physiii/esp-drone/code/docs/en/rst/index.rst

ESP-Drone
===========
:link_to_translation:`zh_CN:[中文]`

**ESP-Drone** is an open source **drone solution** based on Espressif **ESP32/ESP32-S2** Wi-Fi chip, which can be controlled over a **Wi-Fi** network using a mobile APP or gamepad. ESP-Drone supports multiple flight modes, including `Stabilize mode`, `Height-hold mode`, and `Position-hold mode`. With **simple hardware**, **clear and extensible code architecture**, ESP-Drone can be used in **STEAM education** and other fields. The main code is ported from **Crazyflie** open source project with **GPL3.0** protocol.

This document describes the development guide for ESP-Drone project.

==================  ==================  ==================
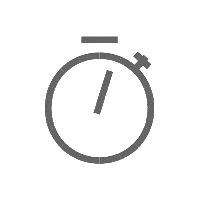
[picture p27: code/docs/_static/get-started.png]
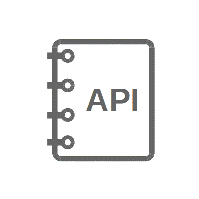
[picture p28: code/docs/_static/api-reference.png]
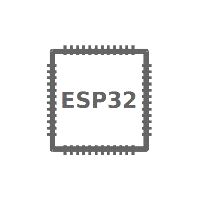
[picture p29: code/docs/_static/hw-reference.png]
_      _    _
------------------  ------------------  ------------------
`Get Started`_      `Develop Guide`_    `H/W Reference`_
==================  ==================  ==================


.. _Get Started: gettingstarted.html


.. _Develop Guide: gettingstarted.html


.. _H/W Reference: gettingstarted.html

.. toctree::
   :hidden:

   Get Started <gettingstarted>
   Set up Development Environment <getespidf>
   Development Guide <developerguide>
   Hardware Reference <hardware>
   Drivers <drivers>
   Flight Control System <system>
   Communications <communication>
   Notice <notice>
