physiii/esp-drone/code/docs/zh_CN/md/index.rst

ESP-Drone
===========

ESP-Drone 是基于乐鑫 ESP32/ESP32-S2 开发的小型无人机解决方案，可使用手机 APP 或游戏手柄通过 Wi-Fi 网络进行连接和控制。目前已支持自稳定飞行、定高飞行、定点飞行等多种模式。该方案硬件结构简单，代码架构清晰完善，方便功能扩展，可用于 STEAM 教育等领域。控制系统代码来自 Crazyflie 开源工程，使用 GPL3.0 开源协议。

本文档包含 ESP-Drone 基本的开发和使用说明。

==================  ==================  ==================
_          _         _
------------------  ------------------  ------------------
`快速入门`_          `开发指引`_         `硬件参考`_
==================  ==================  ==================


.. _快速入门: gettingstarted.html


.. _开发指引: developerguide.html


.. _硬件参考: hardware.html

.. toctree::
   :hidden:

   快速入门 <gettingstarted>
   环境搭建 <getespidf>
   开发指引 <developerguide>
   硬件参考 <hardware.md>
   驱动程序 <drivers.md>
   飞控系统 <system.md>
   通信协议 <communication.md>
   声明 <notice.md>
