physiii/esp-drone/code/docs/en/md/index.rst

ESP-Drone
===========

**ESP-Drone** is an open source **drone solution** based on espressif **ESP32-S2 / ESP32** Wi-Fi chip, which can be controlled through **Wi-Fi** network using mobile APP or gamepad. ESP-Drone supports multiple flight modes, `stabilize`, `height-hold`, `position-hold` and more. With **simple hardware**, **clear and extendible code architecture**, ESP-Drone can be used in **STEAM education** and other fields. The main code ported from **Crazyflie** open source project with **GPL3.0** protocol.

This document describes development and usage guide for the ESP-Drone project

==================  ==================  ==================
_      _    _
------------------  ------------------  ------------------
`Get Started`_      `Develop Guide`_    `H/W Reference`_
==================  ==================  ==================


.. _Get Started: gettingstarted.html


.. _Develop Guide: gettingstarted.html


.. _H/W Reference: gettingstarted.html

.. toctree::
   :hidden:

   Get Started <gettingstarted>
