physiii/esp-drone/code/docs/_static/burst_read_sequence.png

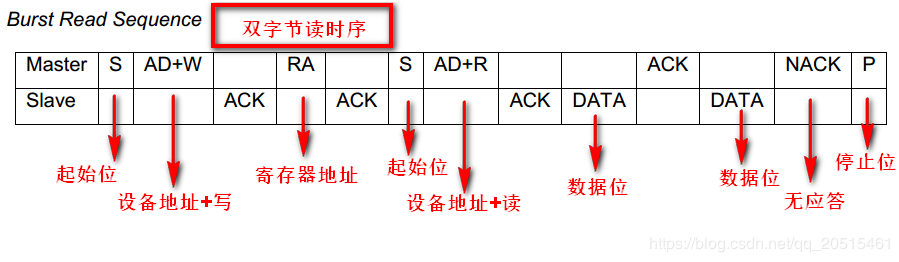
code/docs/_static/burst_read_sequence.png
