physiii/esp-drone/code/docs/_static/burst_write_sequence.png

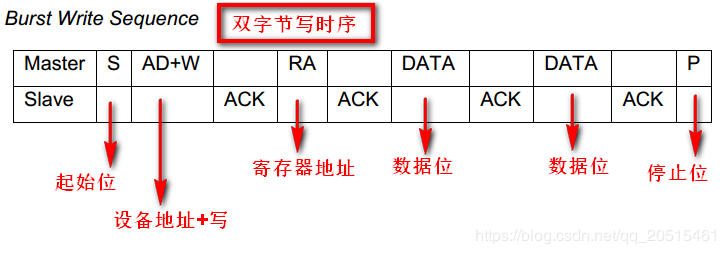
code/docs/_static/burst_write_sequence.png
