physiii/esp-drone/code/docs/_static/cover_page_pdf.jpg

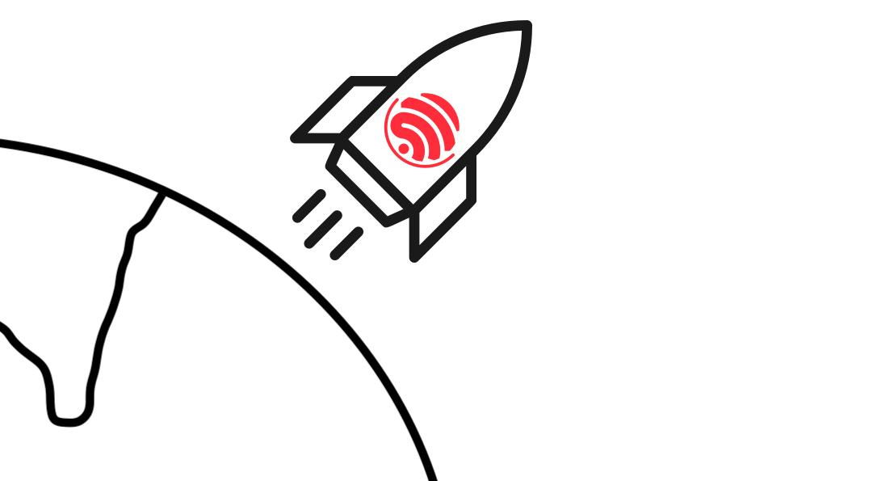
code/docs/_static/cover_page_pdf.jpg
