physiii/esp-drone/code/docs/_static/espdrone_s2_v1_2.png

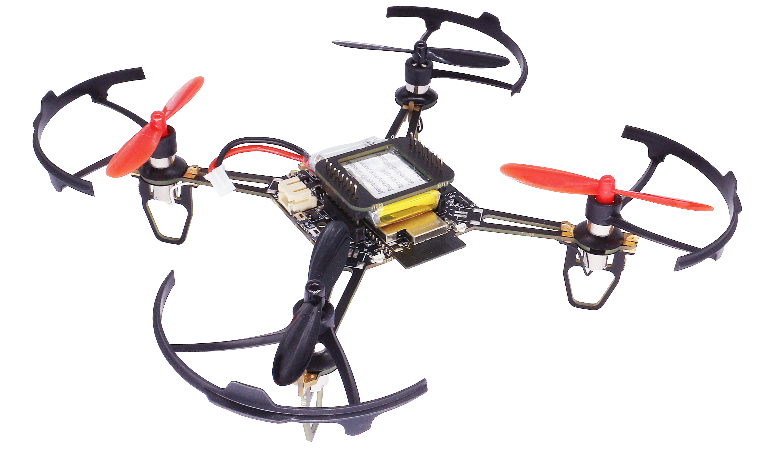
code/docs/_static/espdrone_s2_v1_2.png
