physiii/esp-drone/code/docs/_static/espdrone_s2_v1_2_diretion.png

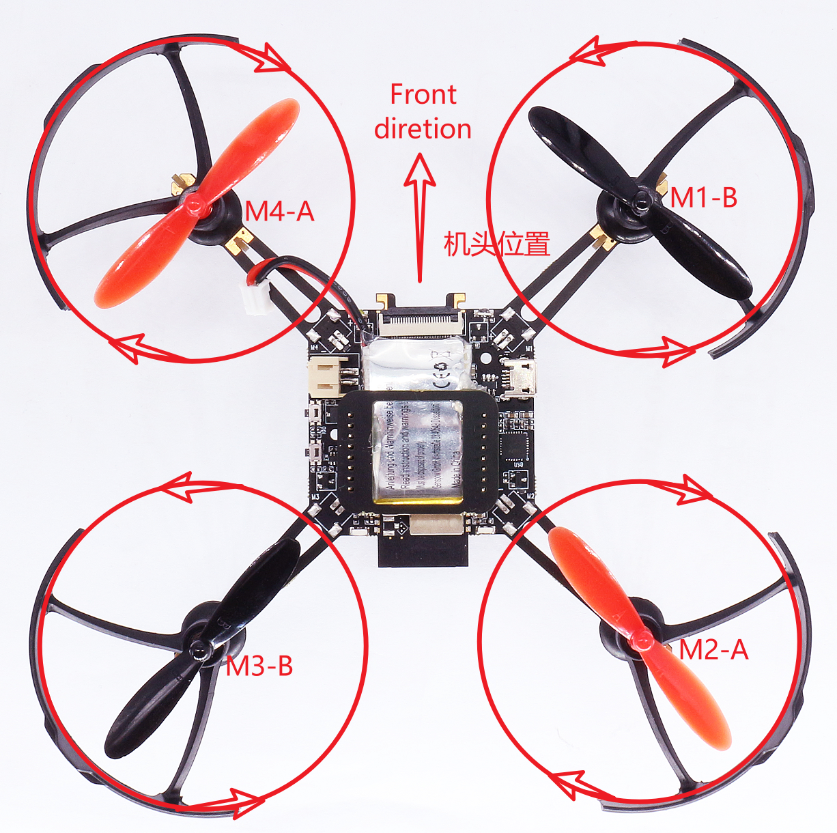
code/docs/_static/espdrone_s2_v1_2_diretion.png
