physiii/esp-drone/code/docs/_static/espilot_app.png

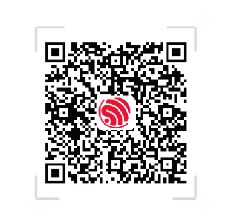
code/docs/_static/espilot_app.png
