physiii/esp-drone/code/docs/_static/esplane_v1_specification.jpg

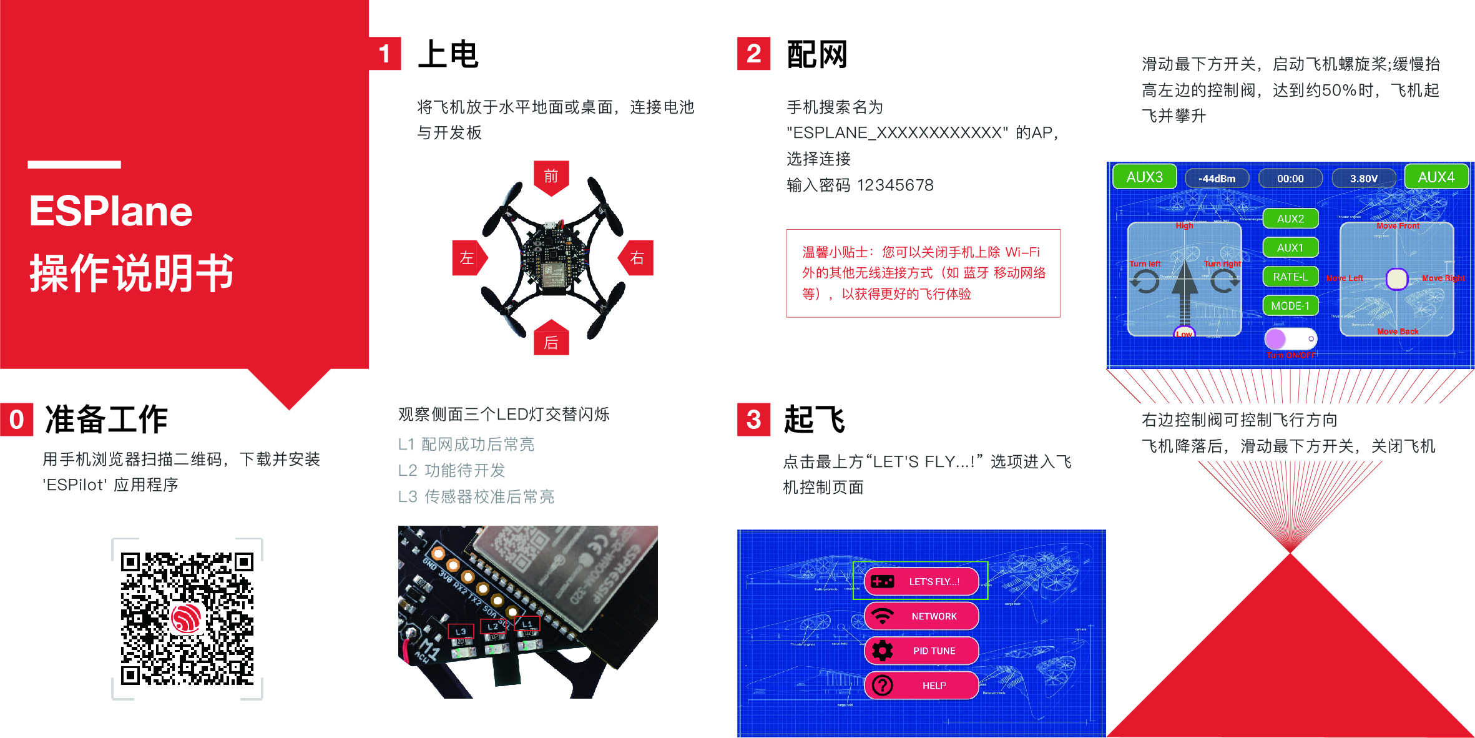
code/docs/_static/esplane_v1_specification.jpg
