physiii/esp-drone/code/docs/_static/gamepad.jpg

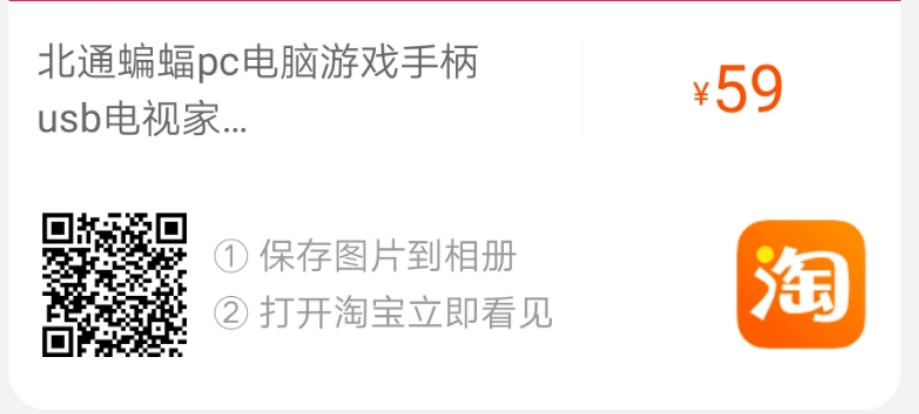
code/docs/_static/gamepad.jpg
