physiii/esp-drone/code/docs/_static/i2c_signal.png

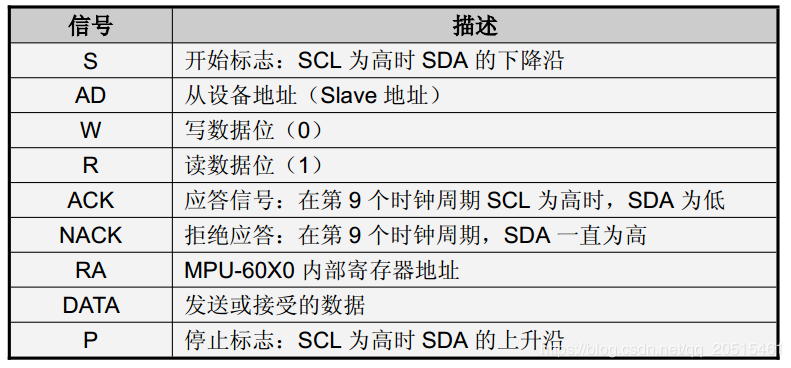
code/docs/_static/i2c_signal.png
