physiii/esp-drone/code/docs/_static/log_motion.png

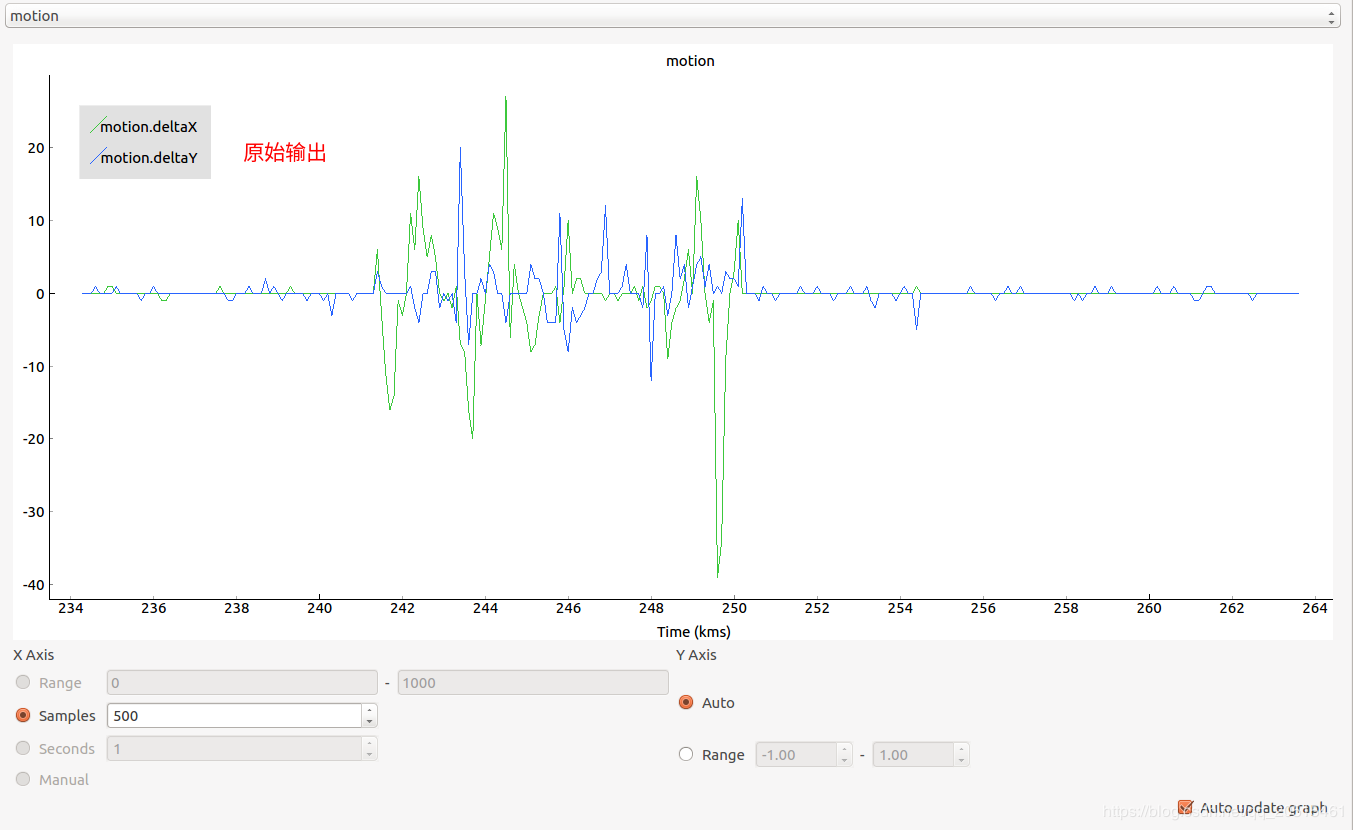
code/docs/_static/log_motion.png
