physiii/esp-drone/code/docs/_static/motors_direction.png

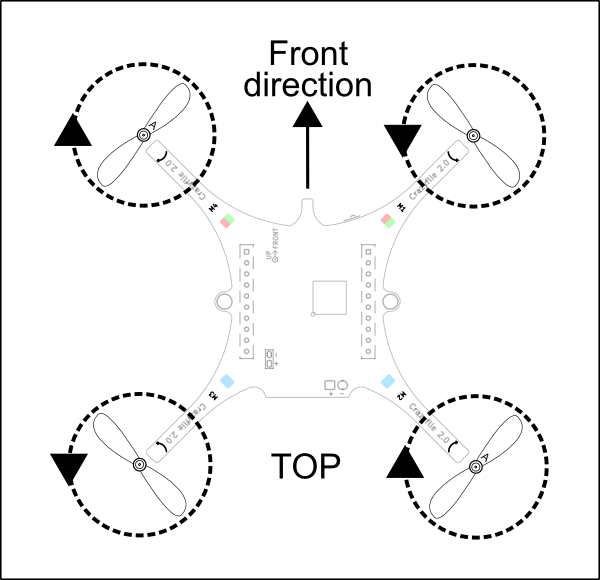
code/docs/_static/motors_direction.png
