physiii/esp-drone/code/docs/_static/mpu6050_raw_value.png

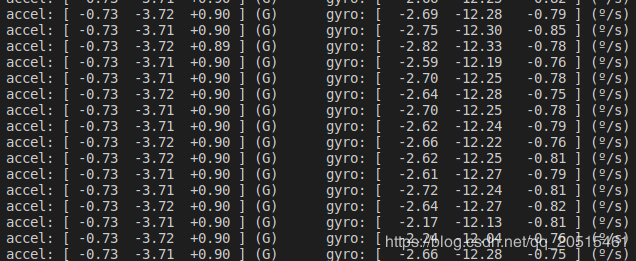
code/docs/_static/mpu6050_raw_value.png
