physiii/esp-drone/code/docs/_static/network_settings.png

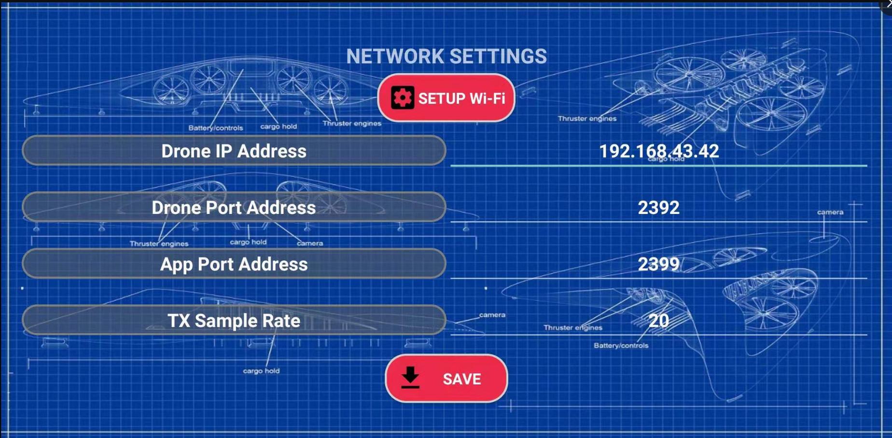
code/docs/_static/network_settings.png
