physiii/esp-drone/code/docs/_static/single_byte_read_sequence.png

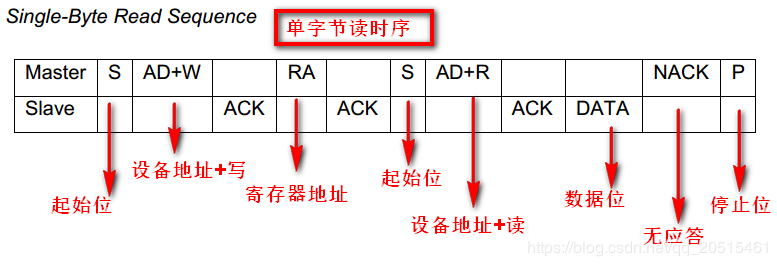
code/docs/_static/single_byte_read_sequence.png
