physiii/esp-drone/code/docs/_static/single_byte_WRITE_sequence.png

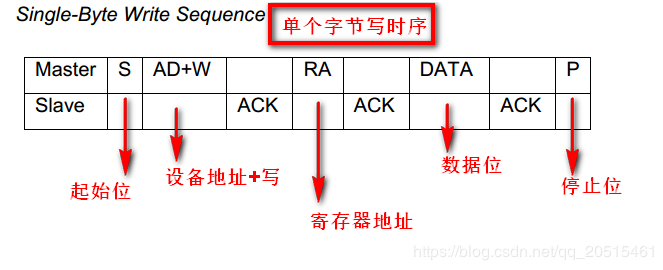
code/docs/_static/single_byte_WRITE_sequence.png
