physiii/esp-drone/code/docs/_static/stabilizerTask_process.png

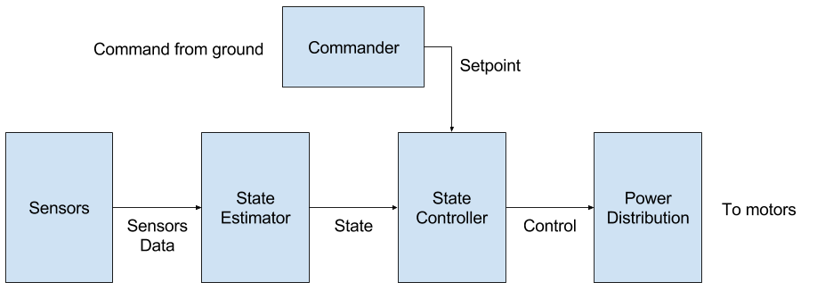
code/docs/_static/stabilizerTask_process.png
