physiii/esp-drone/code/docs/_static/vl53l1x_api.png

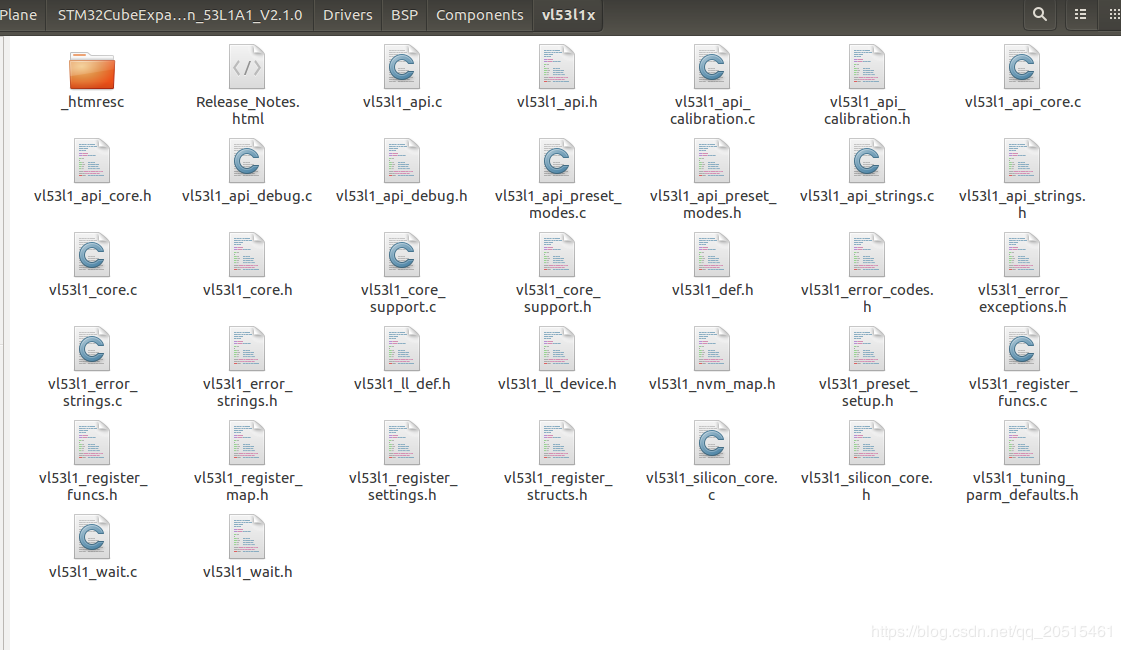
code/docs/_static/vl53l1x_api.png
