physiii/esp-drone/code/docs/_static/vl53l1x_api_platform.png

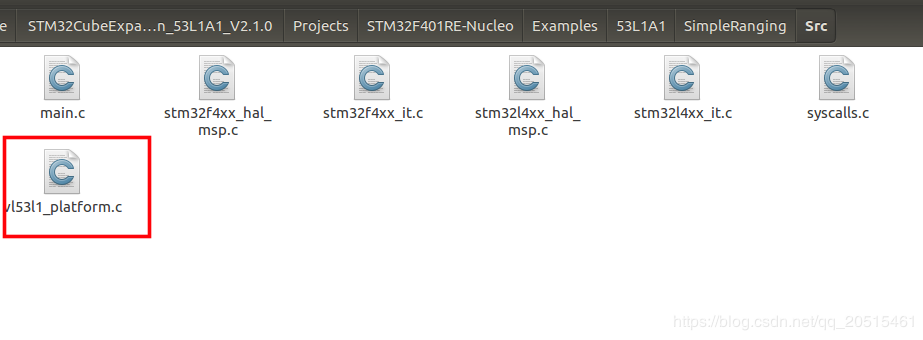
code/docs/_static/vl53l1x_api_platform.png
