physiii/esp-drone/code/docs/_static/vl53lxx_api_platform.png

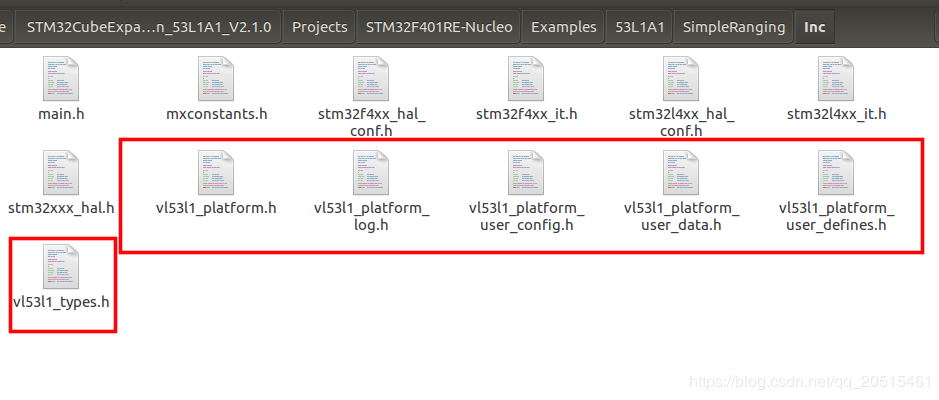
code/docs/_static/vl53lxx_api_platform.png
