physiii/esp-drone/code/docs/_static/vl53lxx_pinmap.png

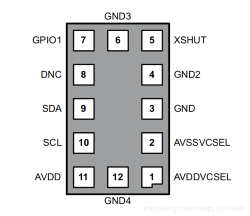
code/docs/_static/vl53lxx_pinmap.png
