physiii/esp-drone/code/docs/_static/vl53lxx_roi_2.png

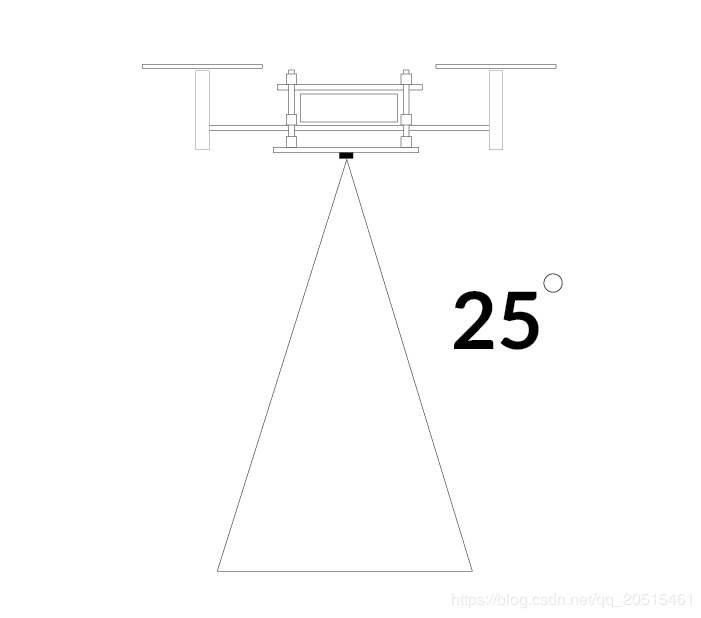
code/docs/_static/vl53lxx_roi_2.png
