physiii/esp-drone/daughter/circuits/documentation/CameraHarnessRadio_C.png

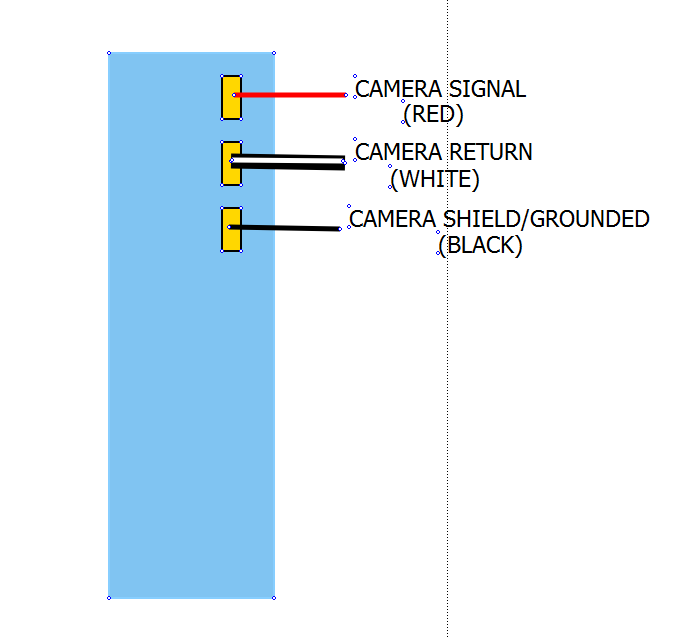
daughter/circuits/documentation/CameraHarnessRadio_C.png
