physiii/esp-drone/daughter/circuits/documentation/ESP32-MCP2551.jpg

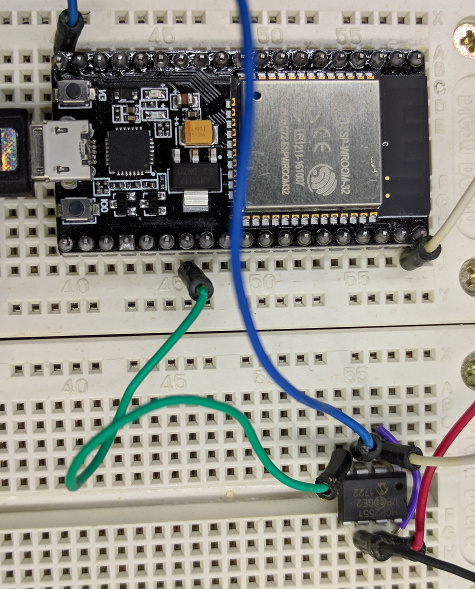
daughter/circuits/documentation/ESP32-MCP2551.jpg
