physiii/esp-drone/daughter/circuits/pics/IMG_20180205_184643.jpg

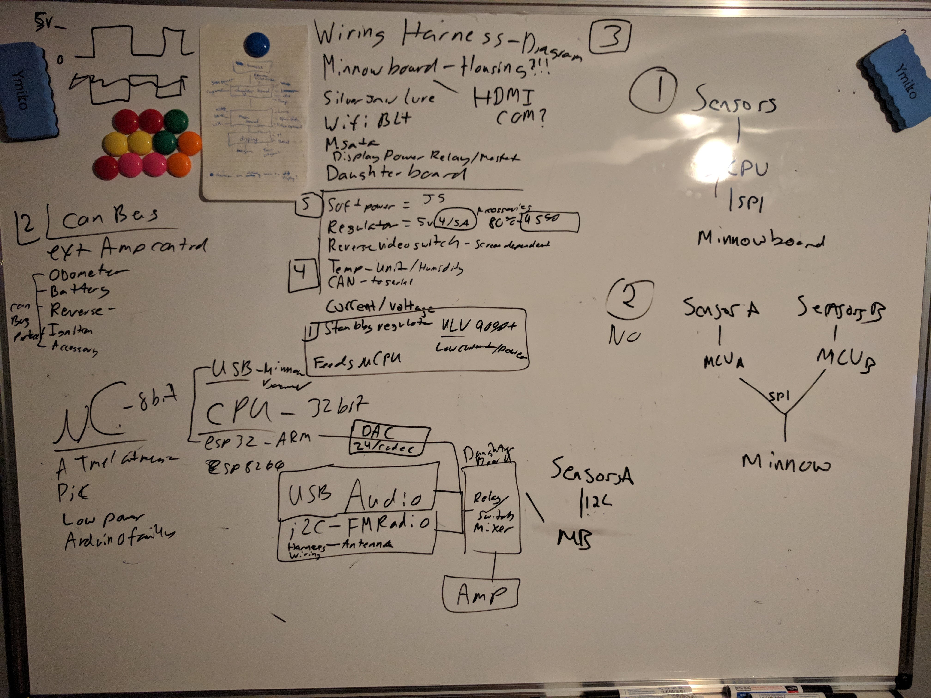
daughter/circuits/pics/IMG_20180205_184643.jpg
