physiii/esp-drone/model/quadrotor.stl

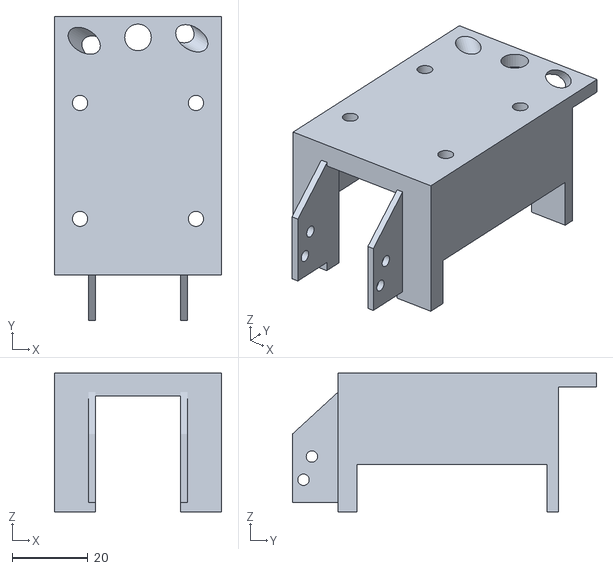
[picture p65: CAD file, 2021-11-07]
model/quadrotor.stl
44.0 x 80.0 x 36.5
