physiii/esp-drone/model/files/TruedWOcuts.stl

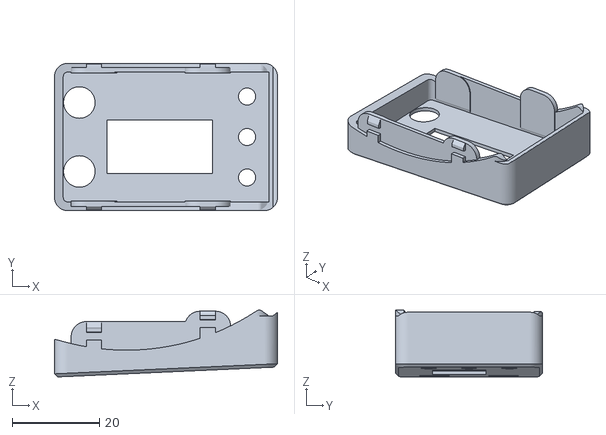
[picture p66: CAD file, 2021-11-07]
model/files/TruedWOcuts.stl
51.0 x 33.7 x 15.3
