physiii/esp-drone/model/files/Trued_v12.stl

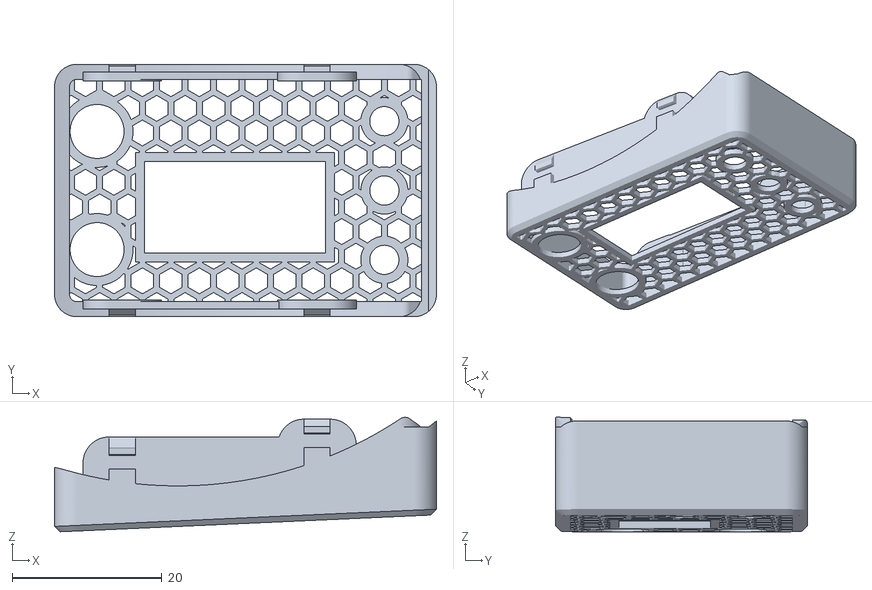
[picture p67: CAD file, 2021-11-07]
model/files/Trued_v12.stl
51.0 x 33.7 x 15.3
