physiii/esp-drone/model/files/Trued_v10.stl

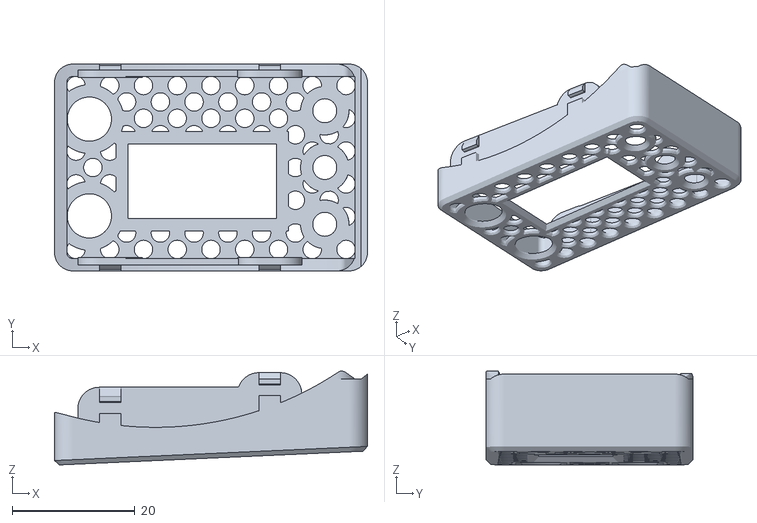
[picture p68: CAD file, 2021-11-07, an earlier design]
model/files/Trued_v10.stl
51.0 x 33.7 x 15.3
