physiii/esp-drone/(list of files, cad)

Other CAD files:
model/quadrotor-mini.blend
model/quadrotor.blend
