physiii/esp-drone/code/docs/zh_CN/md/developerguide.md

# 开发指引

* [环境搭建](./getespidf.md) 
    * [ESP-IDF 环境搭建](getespidf.html#esp-idf) 
    * [ESP32/ESP32-S2 链接脚本修改](getespidf.html#esp32-s2)
    * [获取项目源代码](getespidf.html#id2)
* [驱动程序](./drivers.md)
    * [通用设备](drivers.html#generall)
    * [I2C 总线设备](drivers.html#i2c-devices)
    * [SPI 总线设备](drivers.html#spi-devices)
* [飞控系统](./system.md)
    * [系统启动流程](system.html#id2)
    * [系统任务管理](system.html#id3)
    * [关键任务介绍](system.html#id7)
    * [传感器硬件抽象](system.html#id9)
    * [传感器校准](system.html#id10)
    * [姿态计算](system.html#id15)
    * [控制算法](system.html#id19)
* [通信协议](./communication.md)
    * [通信层级结构](communication.html#id2)
    * [Wi-Fi 通信](communication.html#wi-fi)
    * [UDP 通信](communication.html#udp)
    * [CRTP 协议](communication.html#crtp)
    * [基于 CRTP 协议的应用开发](communication.html#id10)

* [硬件参考](./hardware.md)
    * [已支持硬件列表](hardware.html#id3)
    * [ESP32_S2_Drone_V1_2](hardware.html#esp32-s2-drone-v1-2)
    * [ESPlane_V2_S2](hardware.html#esplane-v2-s2)
    * [ESPlane FC V1](hardware.html#esplane-fc-v1)
