physiii/esp-drone/daughter/circuits/documentation/ESP32-MCP2551 Wiring.ods

ESP32 |  | MCP2551 |  | ESP32-MCP2551.jpg Wire Color
19 | VDD5V | 3 | Vdd | Blue
1 | GND | 2 | Vss | White
14 | GPIO_4 | 4 | RXD | Green
 |  | 5 | Rs | Purple (connects to self Pin 2 Vss)
 |  | 6 | CAN_H | Red
 |  | 7 | CAN_L | Black
