physiii/esp-drone/code/hardware/ESPlane_V2_S2/PCB_ESPlane_V2_S2.pdf

45.0mm

J2J2x1 | J2x2 | J2x3 | J2x4 | J2x5 | J2x6 | J2x7 | J2x8 | J2x9 | J2x10 | J2x11 | J2x12 | J2x13 | J2x14 | J2x15 | J2x16 | J2x17 | J2x18 | J2x19 | J2x20 | J2x21 | J2x22 | J2x23 | J2x24 J2x26 | J2x25

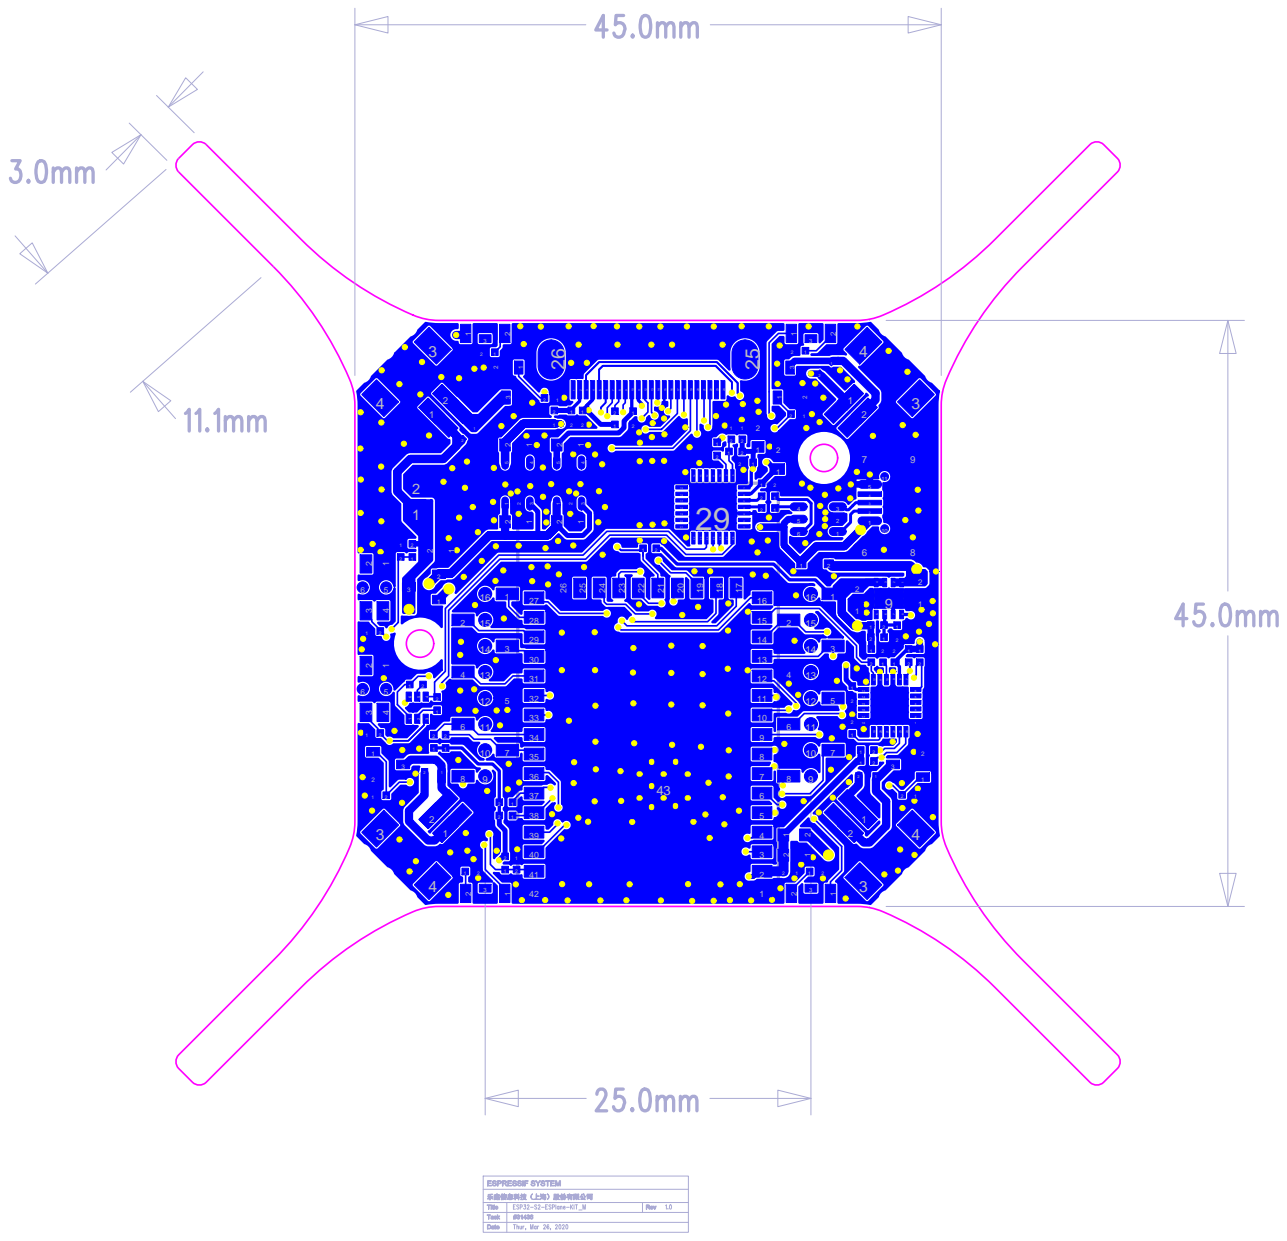
[picture p85: page 1]

45.0mm

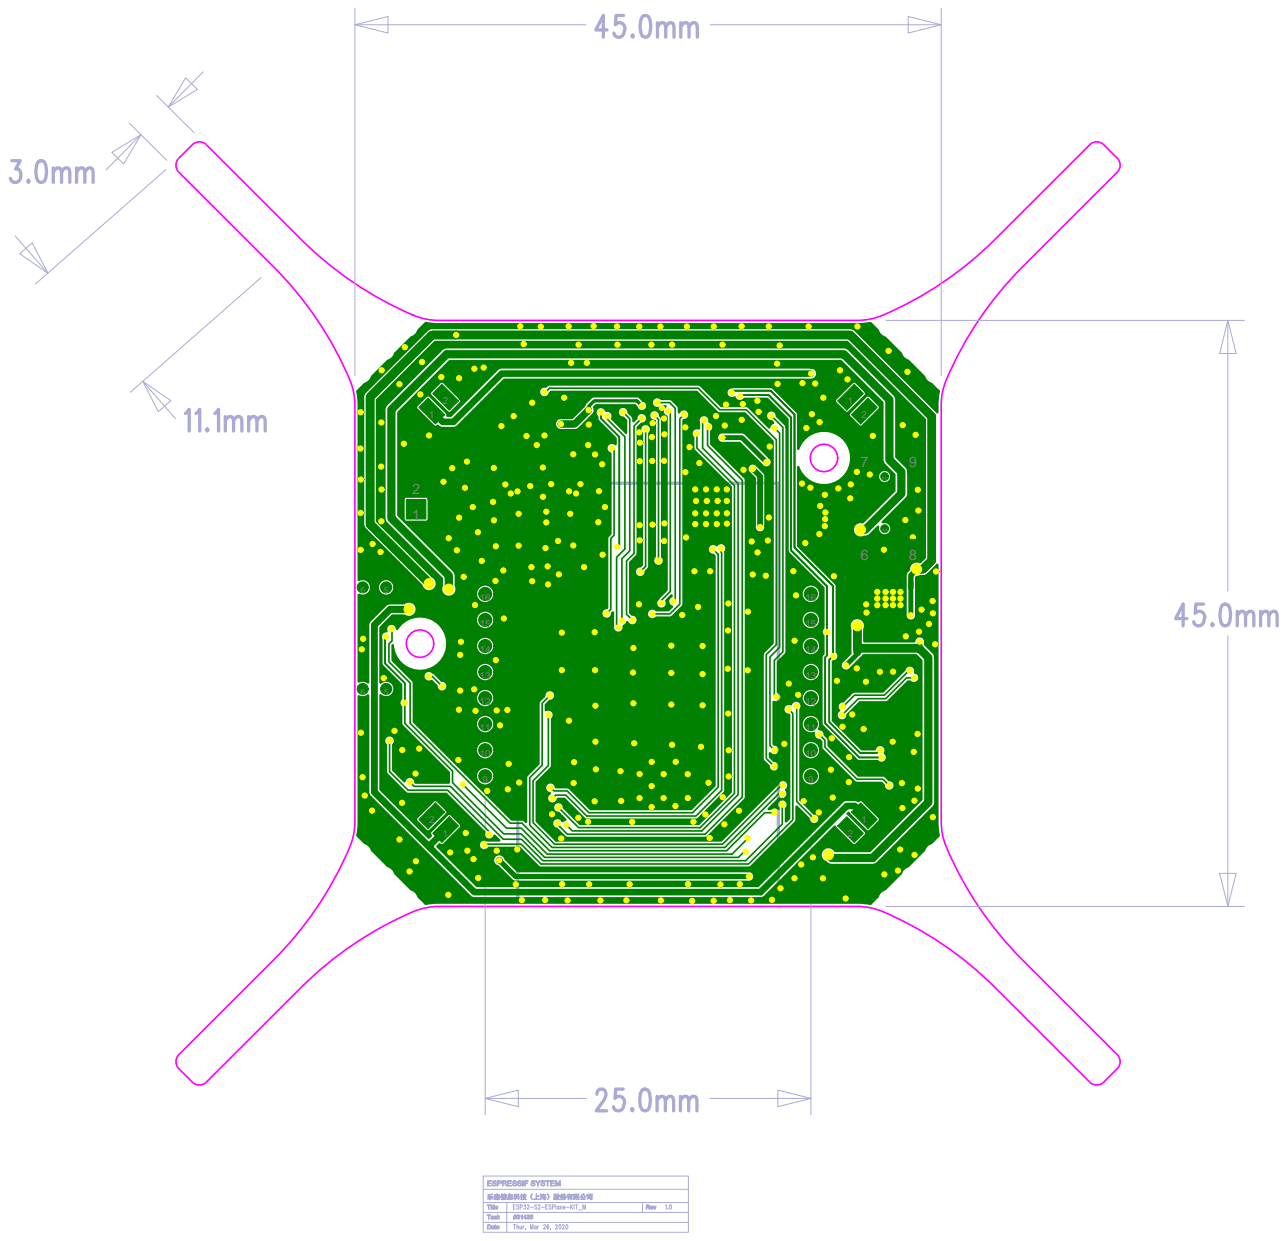
[picture p86: page 2]
Title; ESP32-S2-ESPlane-KIT_M; ESPRESSIF SYSTEM; Task; Date; Thur, Mar 26, 2020; Rev; SW1 SW¹x6; SW¹x5; SW2 SW²x6; SW²x5

乐鑫信息科技（上海）股份有限公司

45.0mm
J2

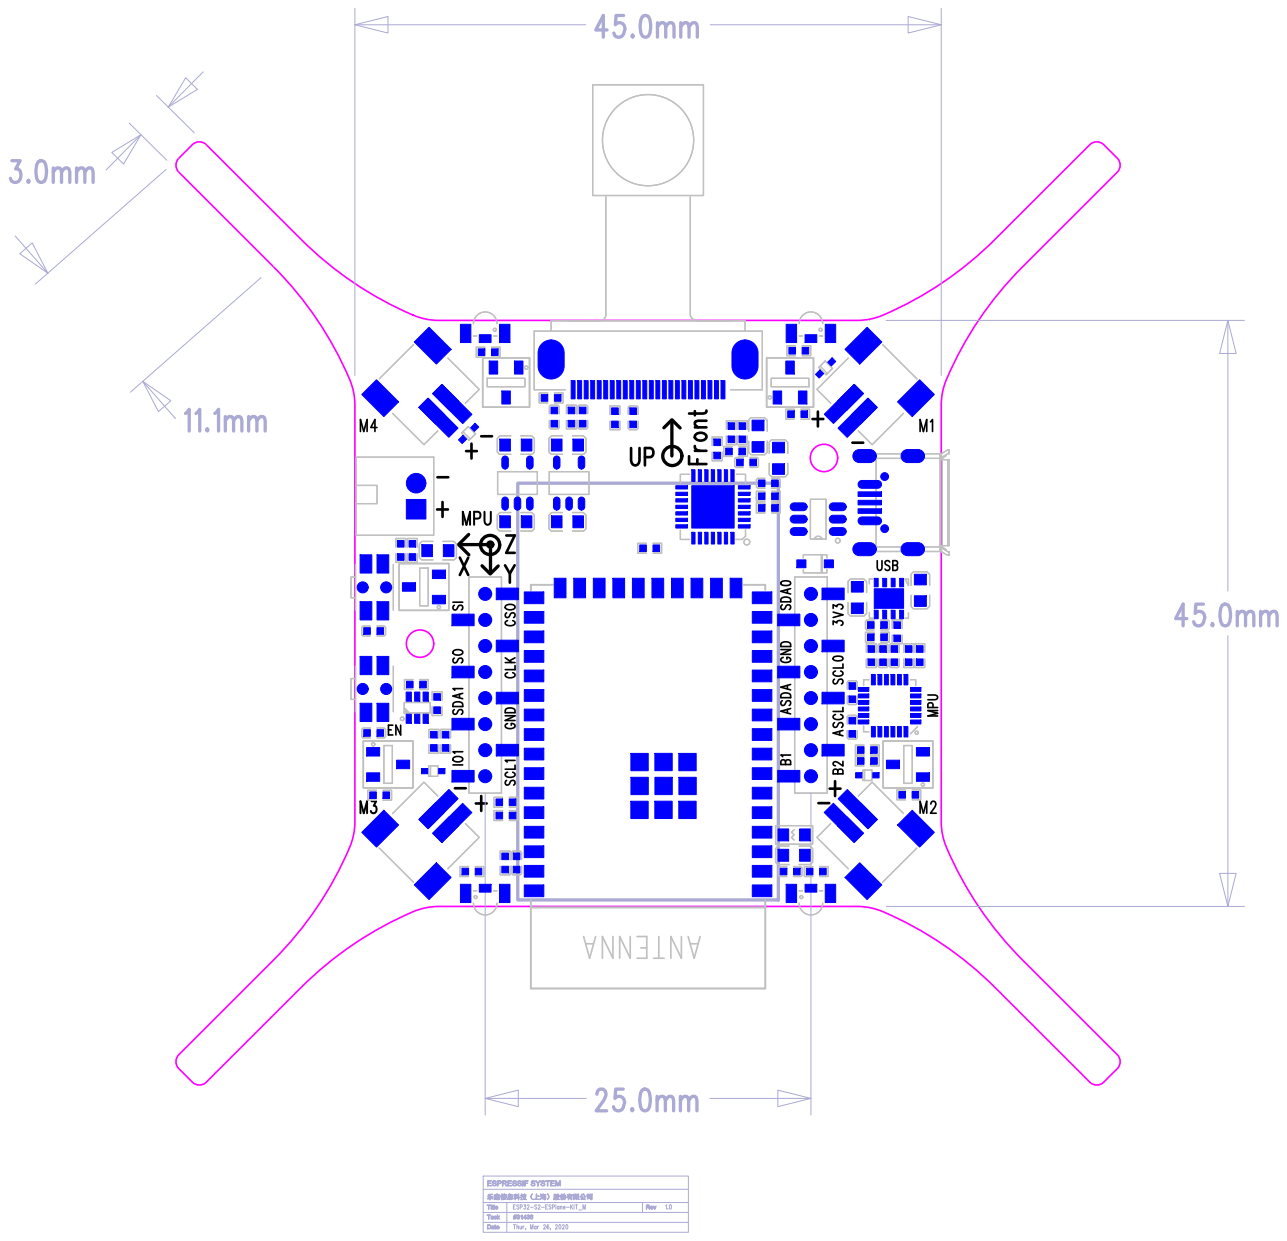
[picture p87: page 3]

45.0mm

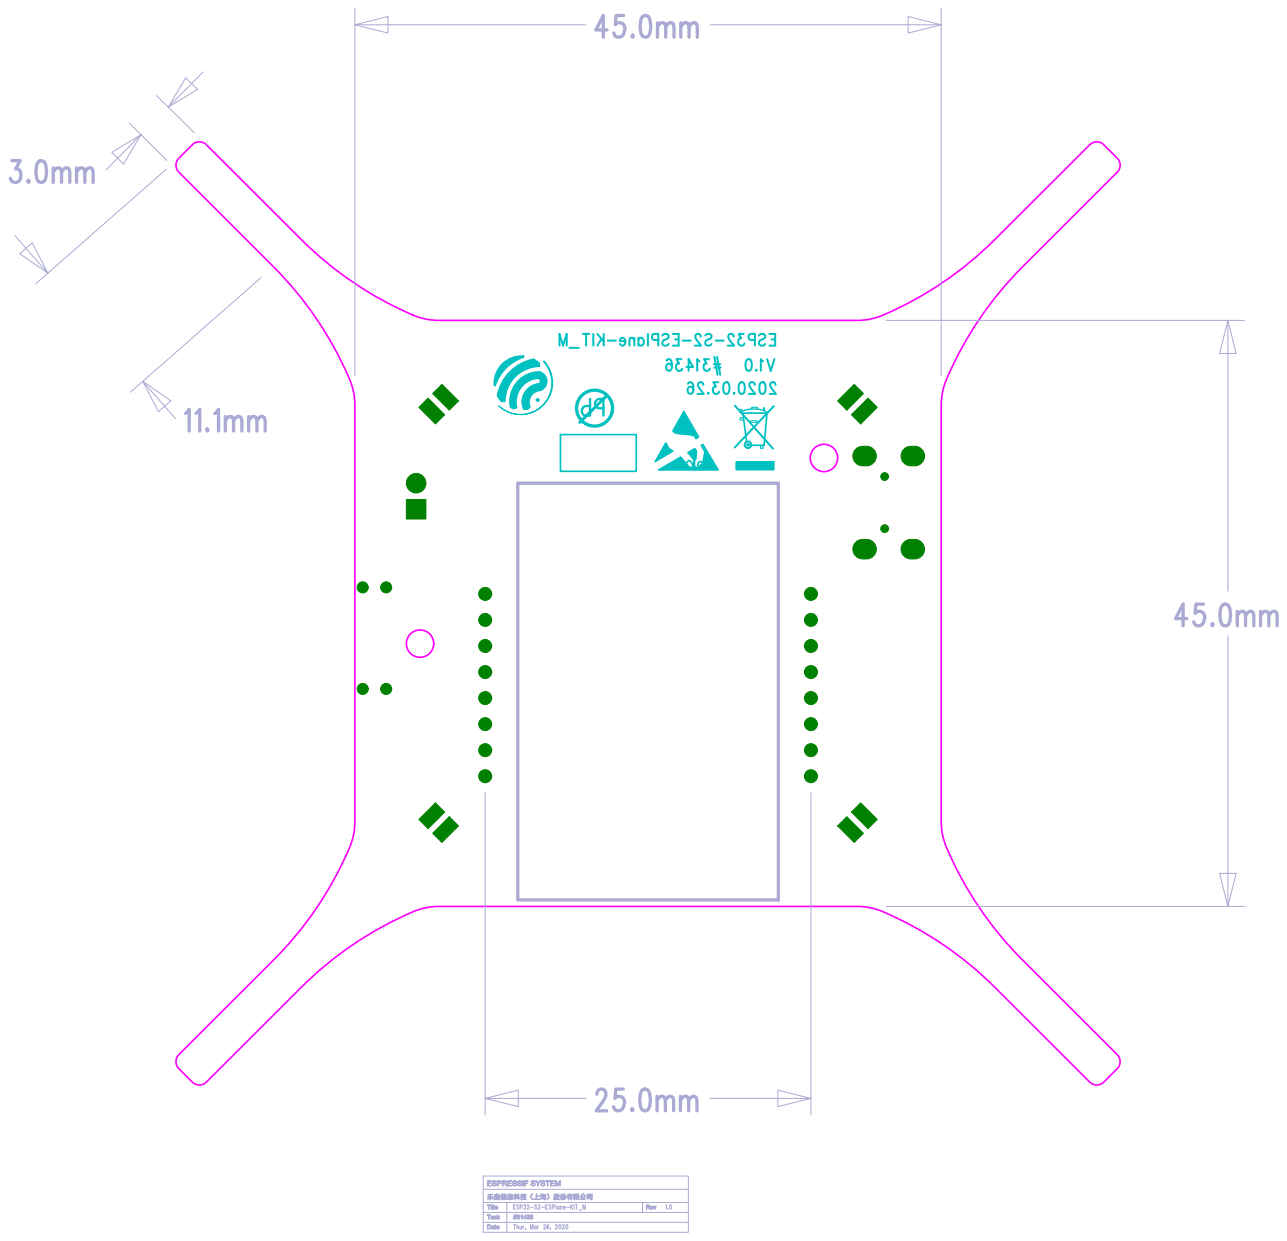
[picture p88: page 4]
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

乐鑫信息科技（上海）股份有限公司

45.0mm
J2

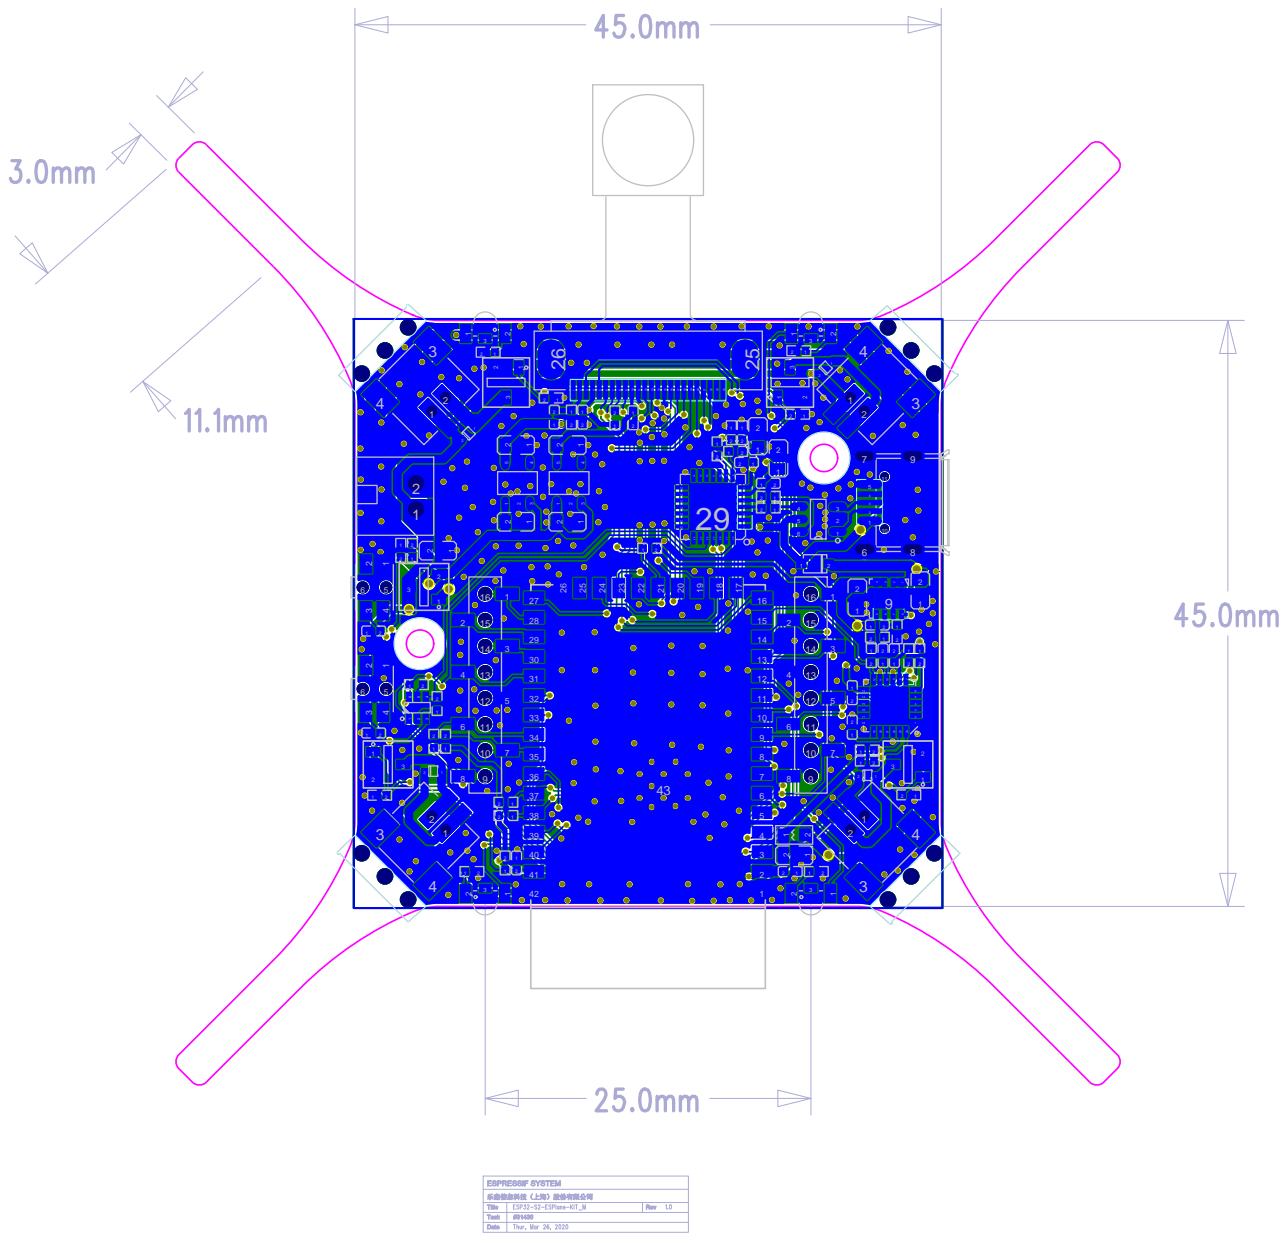
[picture p89: page 5]
