physiii/esp-drone/code/docs/_static/espdrone_file_structure.pdf

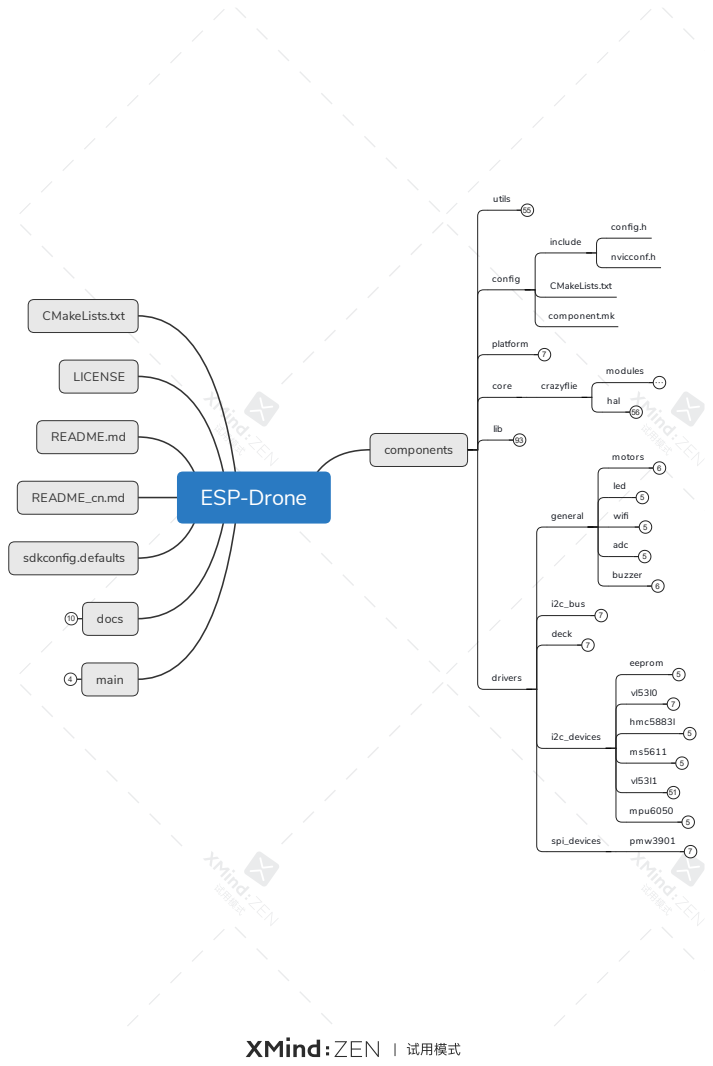
[picture p90: page 1]
ESP-Drone; components; utils; config; include; config.h; nvicconf.h; CMakeLists.txt; component.mk; platform; core; crazyflie; modules; hal; lib; drivers; general; motors; led; wifi; adc; buzzer; i2c_bus; deck; i2c_devices; eeprom; 7 hmc5883l; 51 mpu6050; spi_devices; pmw3901; main; docs; sdkconfig.defaults; README_cn.md; README.md; LICENSE
