physiii/esp-drone/code/docs/_static/stabilizerTask.pdf

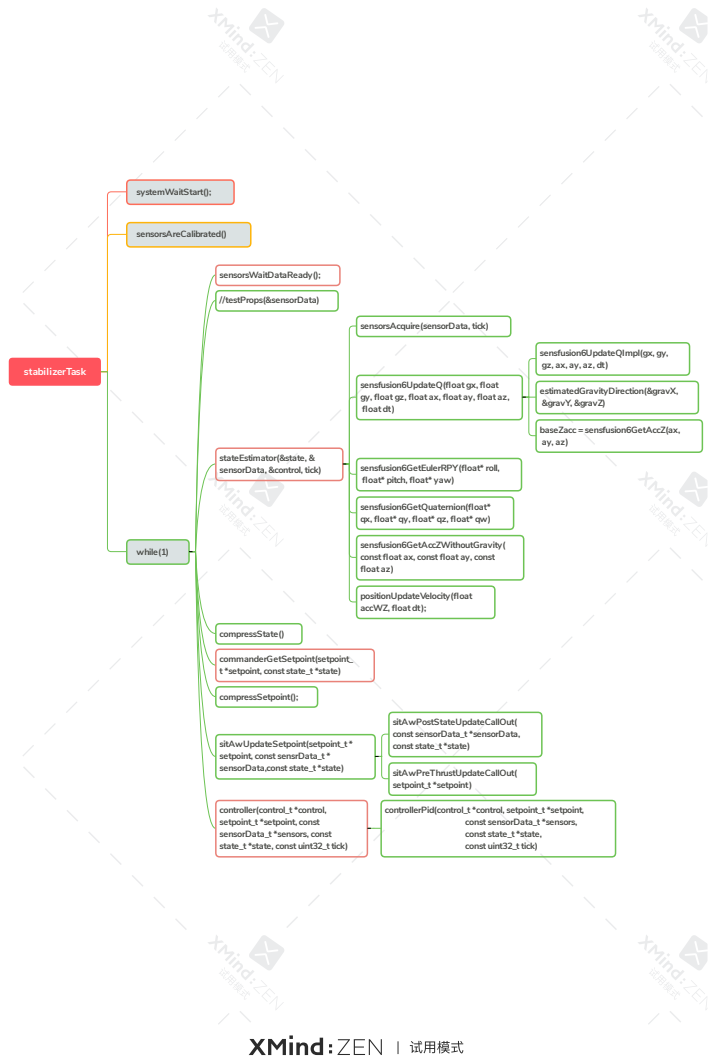
[picture p91: page 1]
stabilizerTask; systemWaitStart();; sensorsAreCalibrated(); while(1); sensorsWaitDataReady();; //testProps(&sensorData); estimatedGravityDirection(&gravX, &gravY, &gravZ); baseZacc = sensfusion6GetAccZ(ax, ay, az); compressState(); compressSetpoint();; sitAwPostStateUpdateCallOut( const sensorData_t *sensorData, const state_t *state); sitAwPreThrustUpdateCallOut( setpoint_t *setpoint)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

sensorsAcquire(sensorData, tick)

sensfusion6UpdateQImpl(gx, gy,

sensfusion6UpdateQ(float gx, float
gy, float gz, float ax, float ay, float az,
float dt)

stateEstimator(&state, &
sensorData, &control, tick)

sensfusion6GetEulerRPY(float* roll,
float* pitch, float* yaw)

sensfusion6GetQuaternion(float*
qx, float* qy, float* qz, float* qw)

sensfusion6GetAccZWithoutGravity(
const float ax, const float ay, const
float az)

positionUpdateVelocity(float
accWZ, float dt);

commanderGetSetpoint(setpoint_
t *setpoint, const state_t *state)

sitAwUpdateSetpoint(setpoint_t *
setpoint, const sensrData_t *
sensorData,const state_t *state)

controllerPid(control_t *control, setpoint_t *setpoint,
