physiii/esp-drone/(list of files, drawings)

Other design files:
code/hardware/ESP32_S2_Drone_V1_2/src/PCB_Mainboard_ESP32_S2_Drone_V1_2.pcb
code/hardware/ESP32_S2_Drone_V1_2/src/SCH_Mainboard_ESP32_S2_Drone_V1_2.DSN
