physiii/esp-drone/code/components/config/include/config.h

/**
 *
 * ESP-Drone Firmware
 * 
 * Copyright 2019-2020  Espressif Systems (Shanghai) 
 * Copyright (C) 2011-2012 Bitcraze AB
 *
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
 * config.h - Main configuration file
 *
 * This file define the default configuration of the copter
 * It contains two types of parameters:
 * - The global parameters are globally defined and independent of any
 *   compilation profile. An example of such define could be some pinout.
 * - The profiled defines, they are parameter that can be specific to each
 *   dev build. The vanilla build is intended to be a "customer" build without
 *   fancy spinning debugging stuff. The developers build are anything the
 *   developer could need to debug and run his code/crazy stuff.
 *
 * The golden rule for the profile is NEVER BREAK ANOTHER PROFILE. When adding a
 * new parameter, one shall take care to modified everything necessary to
 * preserve the behavior of the other profiles.
 *
 * For the flag. T_ means task. H_ means HAL module. U_ would means utils.
 */

#ifndef CONFIG_H_
#define CONFIG_H_
//#include "nrf24l01.h"

//#include "trace.h"
#include "usec_time.h"


#define PROTOCOL_VERSION 4
#define QUAD_FORMATION_X

#ifdef CONFIG_TARGET_ESPLANE_V2_S2
  #define TARGET_MCU_ESP32S2
#elif defined(CONFIG_TARGET_ESPLANE_V1)
  #define TARGET_MCU_ESP32
#elif defined(CONFIG_TARGET_ESP32_S2_DRONE_V1_2)
  #define TARGET_MCU_ESP32S2
#endif

#ifdef STM32F4XX 

  #define CONFIG_BLOCK_ADDRESS    (2048 * (64-1))
  #define MCU_ID_ADDRESS          0x1FFF7A10
  #define MCU_FLASH_SIZE_ADDRESS  0x1FFF7A22
  #ifndef FREERTOS_HEAP_SIZE
    #define FREERTOS_HEAP_SIZE      20000
  #endif
  #define FREERTOS_MIN_STACK_SIZE 150       // M4-FPU register setup is bigger so stack needs to be bigger
  #define FREERTOS_MCU_CLOCK_HZ   168000000

  #define configGENERATE_RUN_TIME_STATS 1
  #define portCONFIGURE_TIMER_FOR_RUN_TIME_STATS() initUsecTimer()
  #define portGET_RUN_TIME_COUNTER_VALUE() usecTimestamp()
#endif


//#define DEBUG_UDP
//#define DEBUG_EP2

// Task priorities. Higher number higher priority
#define STABILIZER_TASK_PRI     5
#define SENSORS_TASK_PRI        4
#define ADC_TASK_PRI            3
#define FLOW_TASK_PRI           3
#define MULTIRANGER_TASK_PRI    3
#define SYSTEM_TASK_PRI         2
#define CRTP_TX_TASK_PRI        2
#define CRTP_RX_TASK_PRI        2
#define EXTRX_TASK_PRI          2
#define ZRANGER_TASK_PRI        2
#define ZRANGER2_TASK_PRI       2
#define PROXIMITY_TASK_PRI      0
#define PM_TASK_PRI             0
#define USDLOG_TASK_PRI         1
#define USDWRITE_TASK_PRI       0
#define PCA9685_TASK_PRI        2
#define CMD_HIGH_LEVEL_TASK_PRI 2
#define BQ_OSD_TASK_PRI         1
#define GTGPS_DECK_TASK_PRI     1
#define LIGHTHOUSE_TASK_PRI     3
#define LPS_DECK_TASK_PRI       5
#define OA_DECK_TASK_PRI        3
#define UART1_TEST_TASK_PRI     1
#define UART2_TEST_TASK_PRI     1
#define LEDSEQCMD_TASK_PRI      1
//if task watchdog triggered,KALMAN_TASK_PRI should set lower or set lower flow frequency
#ifdef TARGET_MCU_ESP32
  #define KALMAN_TASK_PRI         2
  #define LOG_TASK_PRI            1
  #define MEM_TASK_PRI            1
  #define PARAM_TASK_PRI          1
#else
  #define KALMAN_TASK_PRI         1
  #define LOG_TASK_PRI            2
  #define MEM_TASK_PRI            2
  #define PARAM_TASK_PRI          2
#endif

#define SYSLINK_TASK_PRI        3
#define USBLINK_TASK_PRI        3
#define ACTIVE_MARKER_TASK_PRI  3
#define AI_DECK_TASK_PRI        3
#define UART2_TASK_PRI          3
#define WIFILINK_TASK_PRI       3
#define UDP_TX_TASK_PRI         3
#define UDP_RX_TASK_PRI         3
#define UDP_RX2_TASK_PRI        3

// Not compiled
#if 0
  #define INFO_TASK_PRI           2
  #define PID_CTRL_TASK_PRI       2
#endif


// Task names
#define SYSTEM_TASK_NAME        "SYSTEM"
#define LEDSEQCMD_TASK_NAME     "LEDSEQCMD"
#define ADC_TASK_NAME           "ADC"
#define PM_TASK_NAME            "PWRMGNT"
#define CRTP_TX_TASK_NAME       "CRTP-TX"
#define CRTP_RX_TASK_NAME       "CRTP-RX"
#define CRTP_RXTX_TASK_NAME     "CRTP-RXTX"
#define LOG_TASK_NAME           "LOG"
#define MEM_TASK_NAME           "MEM"
#define PARAM_TASK_NAME         "PARAM"
#define SENSORS_TASK_NAME       "SENSORS"
#define STABILIZER_TASK_NAME    "STABILIZER"
#define NRF24LINK_TASK_NAME     "NRF24LINK"
#define ESKYLINK_TASK_NAME      "ESKYLINK"
#define SYSLINK_TASK_NAME       "SYSLINK"
#define USBLINK_TASK_NAME       "USBLINK"
#define WIFILINK_TASK_NAME       "WIFILINK"
#define UDP_TX_TASK_NAME "UDP_TX"
#define UDP_RX_TASK_NAME  "UDP_RX"
#define UDP_RX2_TASK_NAME  "UDP_RX2"
#define PROXIMITY_TASK_NAME     "PROXIMITY"
#define EXTRX_TASK_NAME         "EXTRX"
#define UART_RX_TASK_NAME       "UART"
#define ZRANGER_TASK_NAME       "ZRANGER"
#define ZRANGER2_TASK_NAME      "ZRANGER2"
#define FLOW_TASK_NAME          "FLOW"
#define USDLOG_TASK_NAME        "USDLOG"
#define USDWRITE_TASK_NAME      "USDWRITE"
#define PCA9685_TASK_NAME       "PCA9685"
#define CMD_HIGH_LEVEL_TASK_NAME "CMDHL"
#define MULTIRANGER_TASK_NAME   "MR"
#define BQ_OSD_TASK_NAME        "BQ_OSDTASK"
#define GTGPS_DECK_TASK_NAME    "GTGPS"
#define LIGHTHOUSE_TASK_NAME    "LH"
#define LPS_DECK_TASK_NAME      "LPS"
#define OA_DECK_TASK_NAME       "OA"
#define UART1_TEST_TASK_NAME    "UART1TEST"
#define UART2_TEST_TASK_NAME    "UART2TEST"
#define KALMAN_TASK_NAME        "KALMAN"
#define ACTIVE_MARKER_TASK_NAME "ACTIVEMARKER-DECK"
#define AI_DECK_GAP_TASK_NAME   "AI-DECK-GAP"
#define AI_DECK_NINA_TASK_NAME  "AI-DECK-NINA"
#define UART2_TASK_NAME         "UART2"

#define configBASE_STACK_SIZE CONFIG_BASE_STACK_SIZE

//Task stack sizes
#define SYSTEM_TASK_STACKSIZE         (6 * configBASE_STACK_SIZE)
#define LEDSEQCMD_TASK_STACKSIZE      (2 * configBASE_STACK_SIZE)
#define ADC_TASK_STACKSIZE            (1 * configBASE_STACK_SIZE)
#define PM_TASK_STACKSIZE             (4 * configBASE_STACK_SIZE)
#define CRTP_TX_TASK_STACKSIZE        (2 * configBASE_STACK_SIZE)
#define CRTP_RX_TASK_STACKSIZE        (6 * configBASE_STACK_SIZE)
#define CRTP_RXTX_TASK_STACKSIZE      (1 * configBASE_STACK_SIZE)
#define LOG_TASK_STACKSIZE            (3 * configBASE_STACK_SIZE)
#define MEM_TASK_STACKSIZE            (2 * configBASE_STACK_SIZE)
#define PARAM_TASK_STACKSIZE          (2 * configBASE_STACK_SIZE)
#define SENSORS_TASK_STACKSIZE        (5 * configBASE_STACK_SIZE)
#define STABILIZER_TASK_STACKSIZE     (5 * configBASE_STACK_SIZE)
#define NRF24LINK_TASK_STACKSIZE      (1 * configBASE_STACK_SIZE)
#define ESKYLINK_TASK_STACKSIZE       (1 * configBASE_STACK_SIZE)
#define SYSLINK_TASK_STACKSIZE        (1 * configBASE_STACK_SIZE)
#define USBLINK_TASK_STACKSIZE        (1 * configBASE_STACK_SIZE)
#define WIFILINK_TASK_STACKSIZE       (5 * configBASE_STACK_SIZE)
#define UDP_TX_TASK_STACKSIZE         (2 * configBASE_STACK_SIZE)
#define UDP_RX_TASK_STACKSIZE         (4 * configBASE_STACK_SIZE)
#define UDP_RX2_TASK_STACKSIZE        (1 * configBASE_STACK_SIZE)
#define PROXIMITY_TASK_STACKSIZE      (1 * configBASE_STACK_SIZE)
#define EXTRX_TASK_STACKSIZE          (1 * configBASE_STACK_SIZE)
#define UART_RX_TASK_STACKSIZE        (1 * configBASE_STACK_SIZE)
#define ZRANGER_TASK_STACKSIZE        (2 * configBASE_STACK_SIZE)
#define ZRANGER2_TASK_STACKSIZE       (4 * configBASE_STACK_SIZE)
#define FLOW_TASK_STACKSIZE           (3 * configBASE_STACK_SIZE)
#define USDLOG_TASK_STACKSIZE         (2 * configBASE_STACK_SIZE)
#define USDWRITE_TASK_STACKSIZE       (2 * configBASE_STACK_SIZE)
#define PCA9685_TASK_STACKSIZE        (2 * configBASE_STACK_SIZE)
#define CMD_HIGH_LEVEL_TASK_STACKSIZE (2 * configBASE_STACK_SIZE)
#define MULTIRANGER_TASK_STACKSIZE    (2 * configBASE_STACK_SIZE)
#define ACTIVEMARKER_TASK_STACKSIZE   (1 * configBASE_STACK_SIZE)
#define AI_DECK_TASK_STACKSIZE        (1 * configBASE_STACK_SIZE)
#define UART2_TASK_STACKSIZE          (1 * configBASE_STACK_SIZE)

//The radio channel. From 0 to 125
//TODO:
#define RADIO_RATE_2M 2

#define RADIO_CHANNEL 80
#define RADIO_DATARATE RADIO_RATE_2M
#define RADIO_ADDRESS 0xE7E7E7E7E7ULL

/**
 * \def PROPELLER_BALANCE_TEST_THRESHOLD
 * This is the threshold for a propeller/motor to pass. It calculates the variance of the accelerometer X+Y
 * when the propeller is spinning.
 */
#define PROPELLER_BALANCE_TEST_THRESHOLD  2.5f

/**
 * \def ACTIVATE_AUTO_SHUTDOWN
 * Will automatically shot of system if no radio activity
 */
//#define ACTIVATE_AUTO_SHUTDOWN

/**
 * \def ACTIVATE_STARTUP_SOUND
 * Playes a startup melody using the motors and PWM modulation
 */
//#define ACTIVATE_STARTUP_SOUND

// Define to force initialization of expansion board drivers. For test-rig and programming.
//#define FORCE_EXP_DETECT

/**
 * \def PRINT_OS_DEBUG_INFO
 * Print with an interval information about freertos mem/stack usage to console.
 */
//#define PRINT_OS_DEBUG_INFO


//Debug defines
//#define BRUSHLESS_MOTORCONTROLLER
//#define ADC_OUTPUT_RAW_DATA
//#define UART_OUTPUT_TRACE_DATA
//#define UART_OUTPUT_RAW_DATA_ONLY
//#define IMU_OUTPUT_RAW_DATA_ON_UART
//#define T_LAUCH_MOTORS
//#define T_LAUCH_MOTOR_TEST
//#define MOTOR_RAMPUP_TEST
/**
 * \def ADC_OUTPUT_RAW_DATA
 * When defined the gyro data will be written to the UART channel.
 * The UART must be configured to run really fast, e.g. in 2Mb/s.
 */
//#define ADC_OUTPUT_RAW_DATA

#if defined(UART_OUTPUT_TRACE_DATA) && defined(ADC_OUTPUT_RAW_DATA)
#  error "Can't define UART_OUTPUT_TRACE_DATA and ADC_OUTPUT_RAW_DATA at the same time"
#endif

#if defined(UART_OUTPUT_TRACE_DATA) || defined(ADC_OUTPUT_RAW_DATA) || defined(IMU_OUTPUT_RAW_DATA_ON_UART)
#define UART_OUTPUT_RAW_DATA_ONLY
#endif

#if defined(UART_OUTPUT_TRACE_DATA) && defined(T_LAUNCH_ACC)
#  error "UART_OUTPUT_TRACE_DATA and T_LAUNCH_ACC doesn't work at the same time yet due to dma sharing..."
#endif

#endif /* CONFIG_H_ */
