physiii/esp-drone/(notices)

Notices in the files:
code/components/drivers/i2c_devices/ms5611/ms5611.c:
This program is free software: you can redistribute it and/or modify
it under the terms of the GNU General Public License as published by
the Free Software Foundation, in version 3.
